NVson99/PCB_NODE_LORA_PROJECTS/DO AN TOT NGHIEP/Node_lora_altium/Image/bottom.png

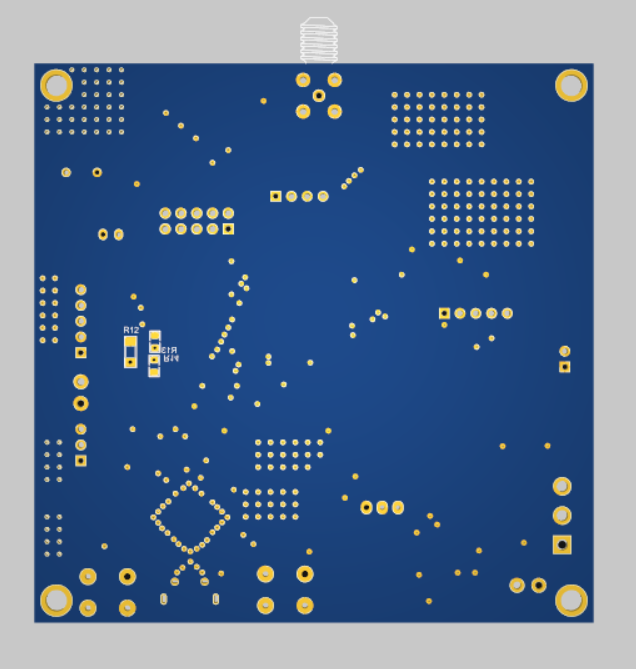
DO AN TOT NGHIEP/Node_lora_altium/Image/bottom.png
