NVson99/PCB_NODE_LORA_PROJECTS/DO AN TOT NGHIEP/Node_lora_altium/Image/TOP.2D.png

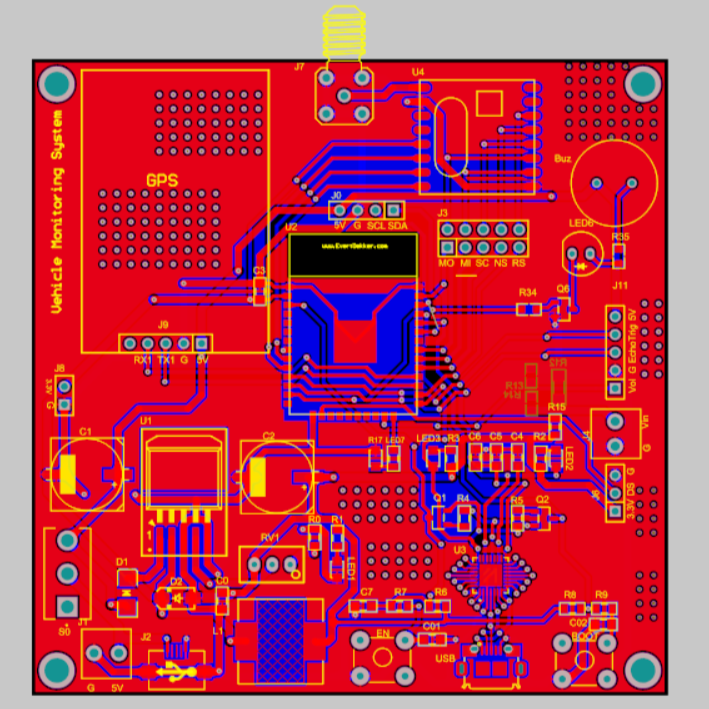
DO AN TOT NGHIEP/Node_lora_altium/Image/TOP.2D.png
