NVson99/PCB_NODE_LORA_PROJECTS/DO AN TOT NGHIEP/Node_lora_altium/Image/top.3D_2.png

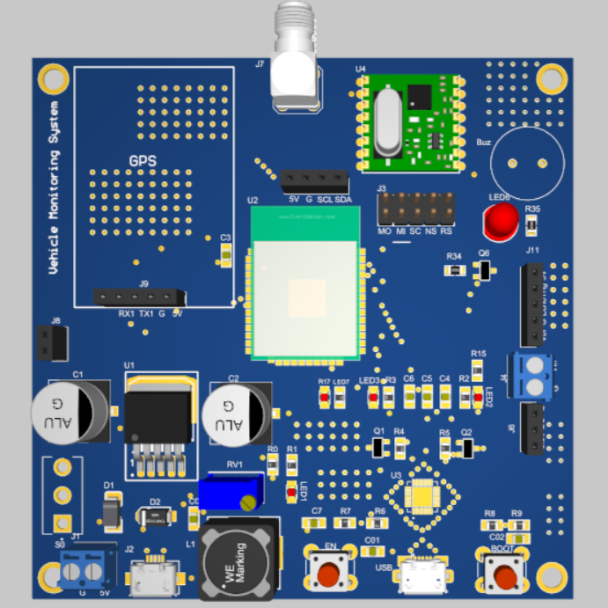
DO AN TOT NGHIEP/Node_lora_altium/Image/top.3D_2.png
