NVson99/PCB_NODE_LORA_PROJECTS/DO AN TOT NGHIEP/Node_lora_altium/BOM/BOM.csv

Comment | Description | Designator | Quantity | Man. Part Number
Button 4pin | Button 4pin | BOOT, EN | 2
PS1240P02BT | Buzzers Transducer, Externally Driven Piezo 3V 4kHz 60dB @ 3V, 10cm Through Hole PC Pins | Buz | 1
10uF | Cap SMD | C0, C4, C5, C7 | 4
1nF | Cap SMD | C01, C02 | 2
330uF | Polarized Capacitor (Axial) | C1, C2 | 2
102 | Cap SMD | C3 | 1
1uF | Cap SMD | C6 | 1
Diode SMD | Default Diode | D1 | 1
SS34 | DIODE, SCHOTTKY, 40V, 3A | D2 | 1
JP4 | WR-PHD 2.54 mm Angled Socket Header | J0 | 1
KF2 |  | J1, J4 | 2
USB-5 |  | J2 | 1
JP5x2 | WR-PHD 2.54 mm Dual Socket Header | J3 | 1
JP3 | WR-PHD 2.54 mm Angled Socket Header | J6 | 1
210111003 | CONNECTOR ANTEN | J7 | 1
JP2 | WR-PHD 2.54 mm Angled Socket Header | J8 | 1
JP5 | WR-PHD 2.54 mm Angled Socket Header | J9, J11 | 2
33uH |  | L1 | 1
LED |  | LED1, LED2, LED3, LED7 | 4
LED5MM_RED | LED, THD, 5MM, RED | LED6 | 1
SS8050 | BJT, NPN, 25v, 1.5A, SMD, SOT23 | Q1, Q2, Q6 | 3
330 | Resistor | R0 | 1
1k | Resistor | R1, R2, R3, R7, R9, R17 | 6
10K | Resistor | R4, R5, R6, R8 | 4
0.1R | RESISTOR, SMD | R12 | 1
100K | RESISTOR, SMD | R13 | 1
10K | RESISTOR, SMD | R14 | 1
4.7K | Resistor | R15 | 1
3.9K | RESISTOR, SMD | R34 | 1
440 | RESISTOR, SMD | R35 | 1
RV20K | Variable Resistor | RV1 | 1
500SSP1S2M2QEA | Slide Switch SPDT Through Hole | S0 | 1
LM2596 |  | U1 | 1
ESP32S_Module | Esp-32S | U2 | 1
CP2102 | USB to USRT converter | U3 | 1
SW96 |  | U4 | 1
OLED_Sh116 1.3" | OLED, SSD1306, 0.96", 128X64, BREAKOUT I2C | U5 | 1
CONN_USB_MICROB | CONN, USB, MICRO B, R/A, SMD, BOTTOM MOUNT | USB | 1
