NVson99/PCB_NODE_LORA_PROJECTS/DO AN TOT NGHIEP/Node_lora_altium/Gerber file/STEP_[No Variations] for Node_Bus.PcbDoc.step

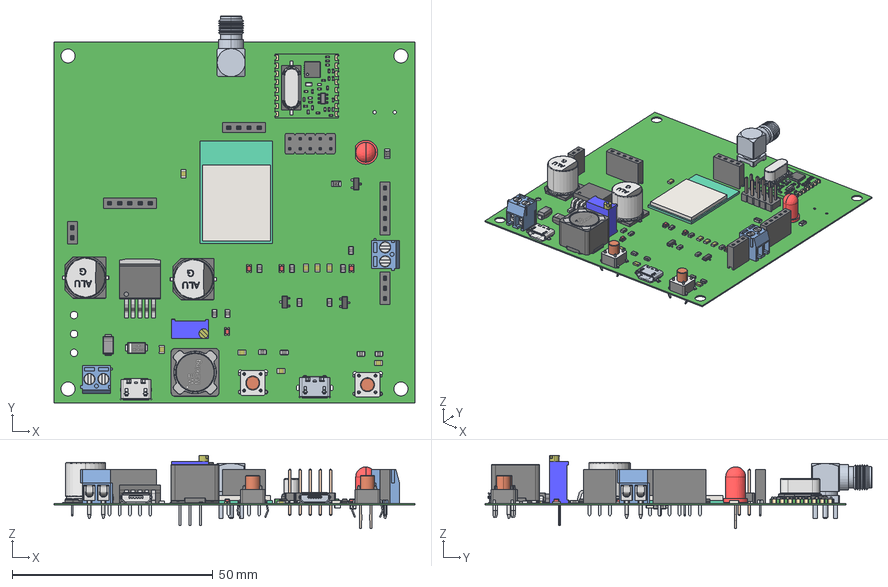
[picture p117: CAD file, 2026-10-10]
DO AN TOT NGHIEP/Node_lora_altium/Gerber file/STEP_[No Variations] for Node_Bus.PcbDoc.step
90.0 x 96.5 x 18.3 mm
6130xx11821_PIN x 19
SW3dPS-smt_resistor_packages x 8
SW3dPS-0805 SMD Resistor x 12
User Library-led_0805-red x 4
Extruded x 2
User Library-RFM22B_Board
User Library-RFM22B_SW3dPS-inductor_0402
User Library-RFM22B_SW3dPS-SOT-23-6
User Library-RFM22B_Cap0402 x 19
User Library-RFM22B_SW3dPS-inductor_0402_white x 5
User Library-RFM22B_SW3dPS-inductor_0603_white
User Library-RFM22B_QFN20
User Library-RFM22B_SW3dPS-hc49_cystal
User Library-RFM22B_Goldcontact x 16
User Library-Potenciometro Vertical
User Library-RES_2013-0805 x 4
1206 SMD Resistor
User Library-SOT23-2 x 3
LED-D5R
Umspritzung12-12_1
12x12-9mm
Core PD 12x12-9
Glue
Leadframe x 2
PIN 1
PIN 2
PIN 3
PIN 4
SMA-J-P-X-RA-TH1
6911031100xx_CAGE x 4
6911031100xx_PIN x 4
6911031100xx_VIS x 4
6130xx21121_PIN x 10
Micro USB
SW3dPS- x 2
User Library-DIOM5528X26
User Library-DO-214Aa SMA
User Library-ALU-G_Pins_1 x 2
User Library-ALU-G_Fuss_1 x 2
User Library-ALU-G_K_X_F6rper_1 x 2
User Library-ALU-G_Beschriftung_1 x 2
