NVson99/PCB_NODE_LORA_PROJECTS/DO AN CN/Node_Lora_V1/schematic/Schematic.pdf

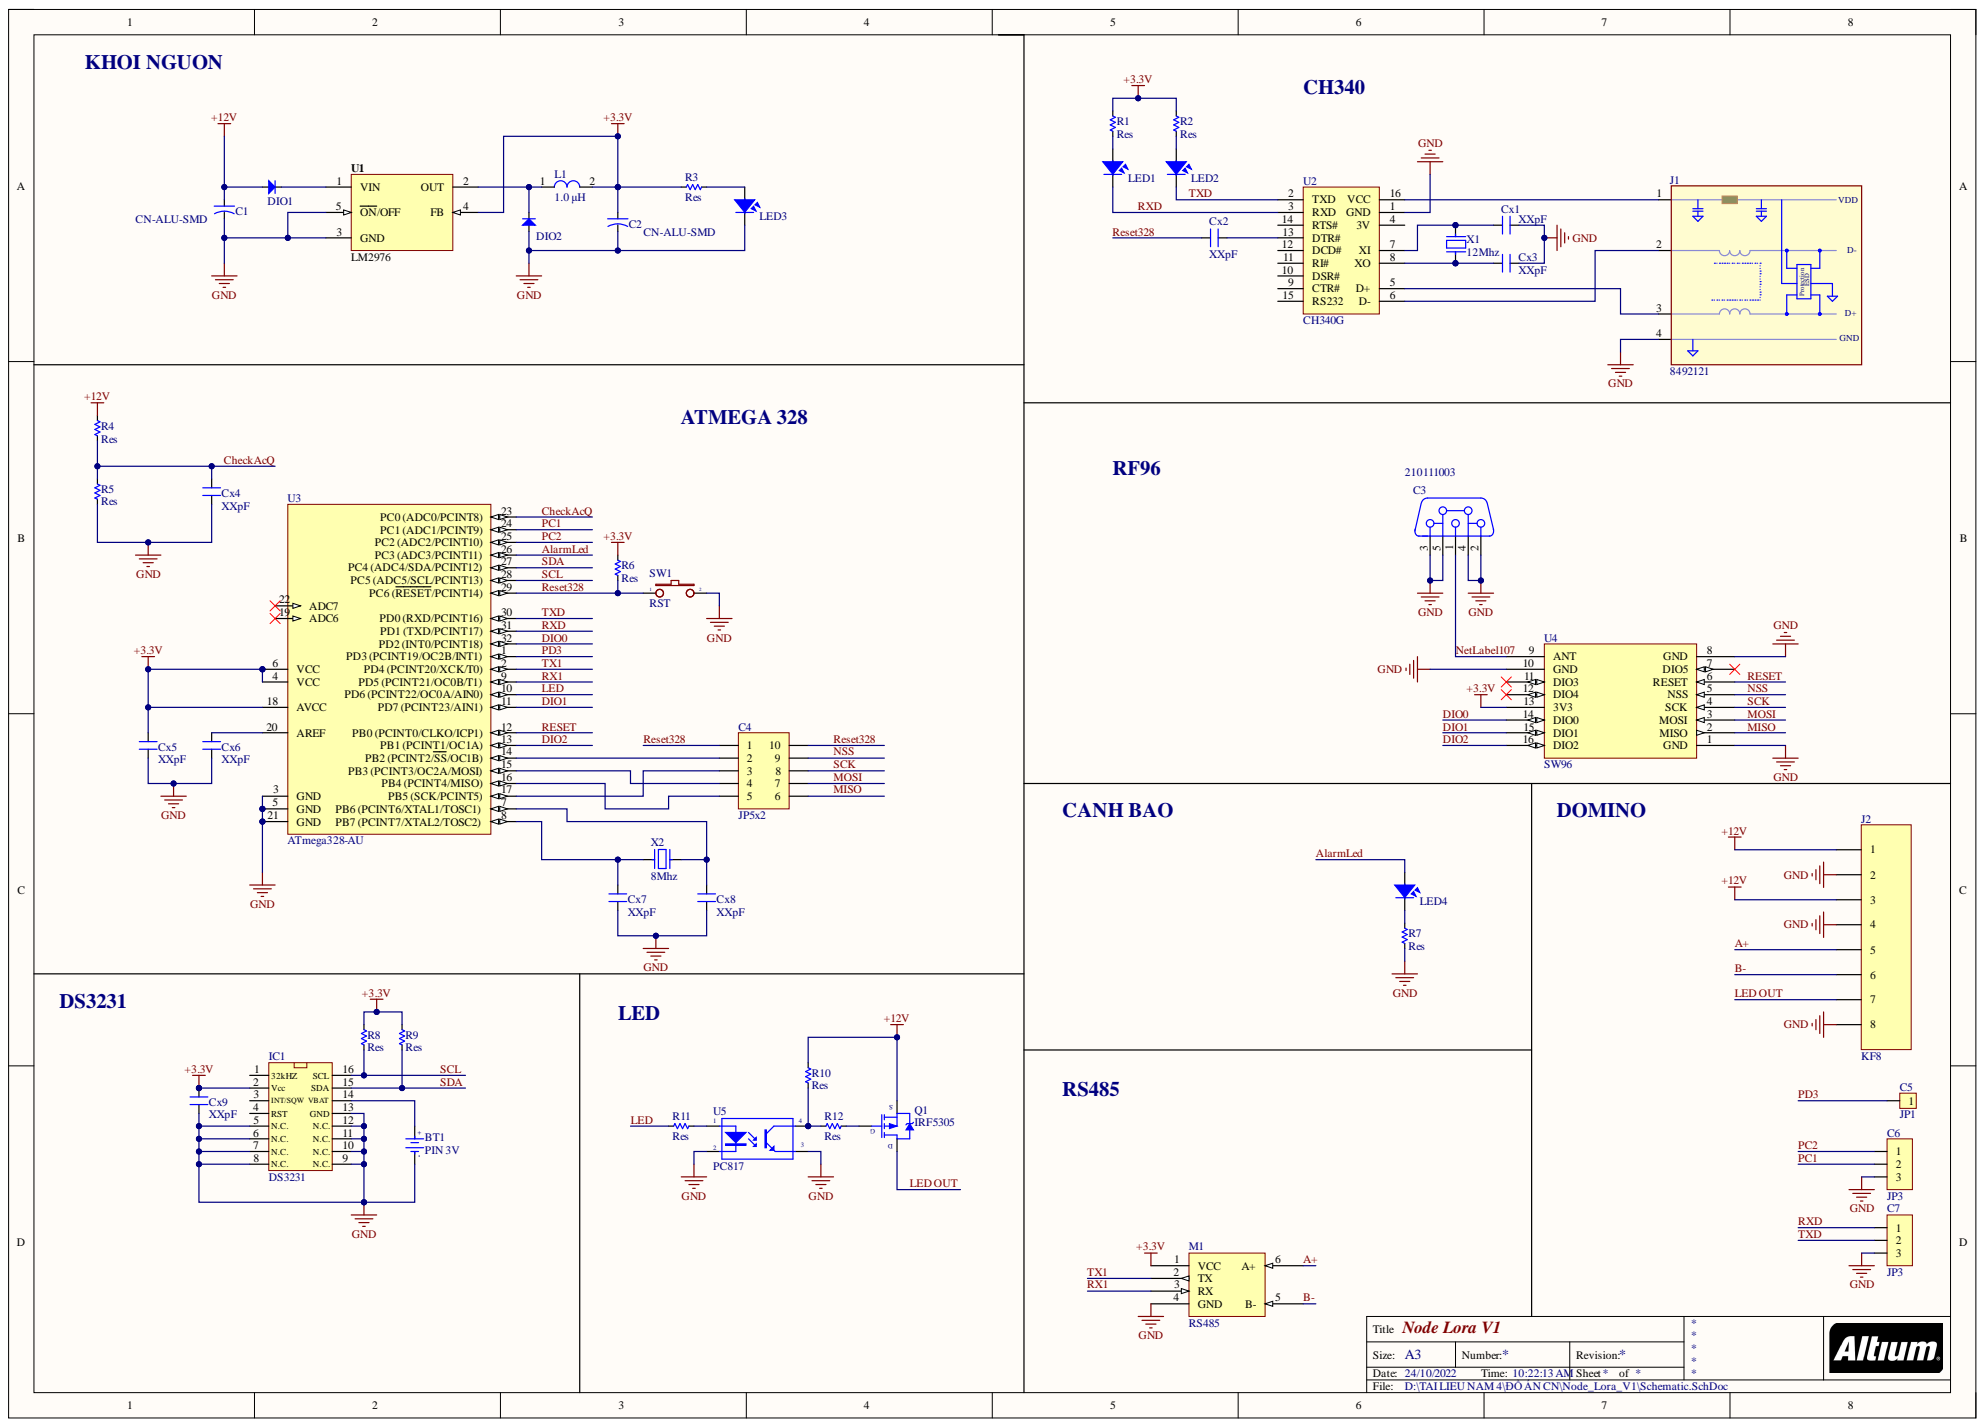
[picture p118: page 1]

N.C. 5
N.C. 6

D:\TAILIEU NAM 4\ĐỒ ÁN CN\Node_Lora_V1\Schematic.SchDoc
