NVson99/PCB_NODE_LORA_PROJECTS/DO AN TOT NGHIEP/Node_lora_altium/Gerber file/Assembly Drawings.pdf

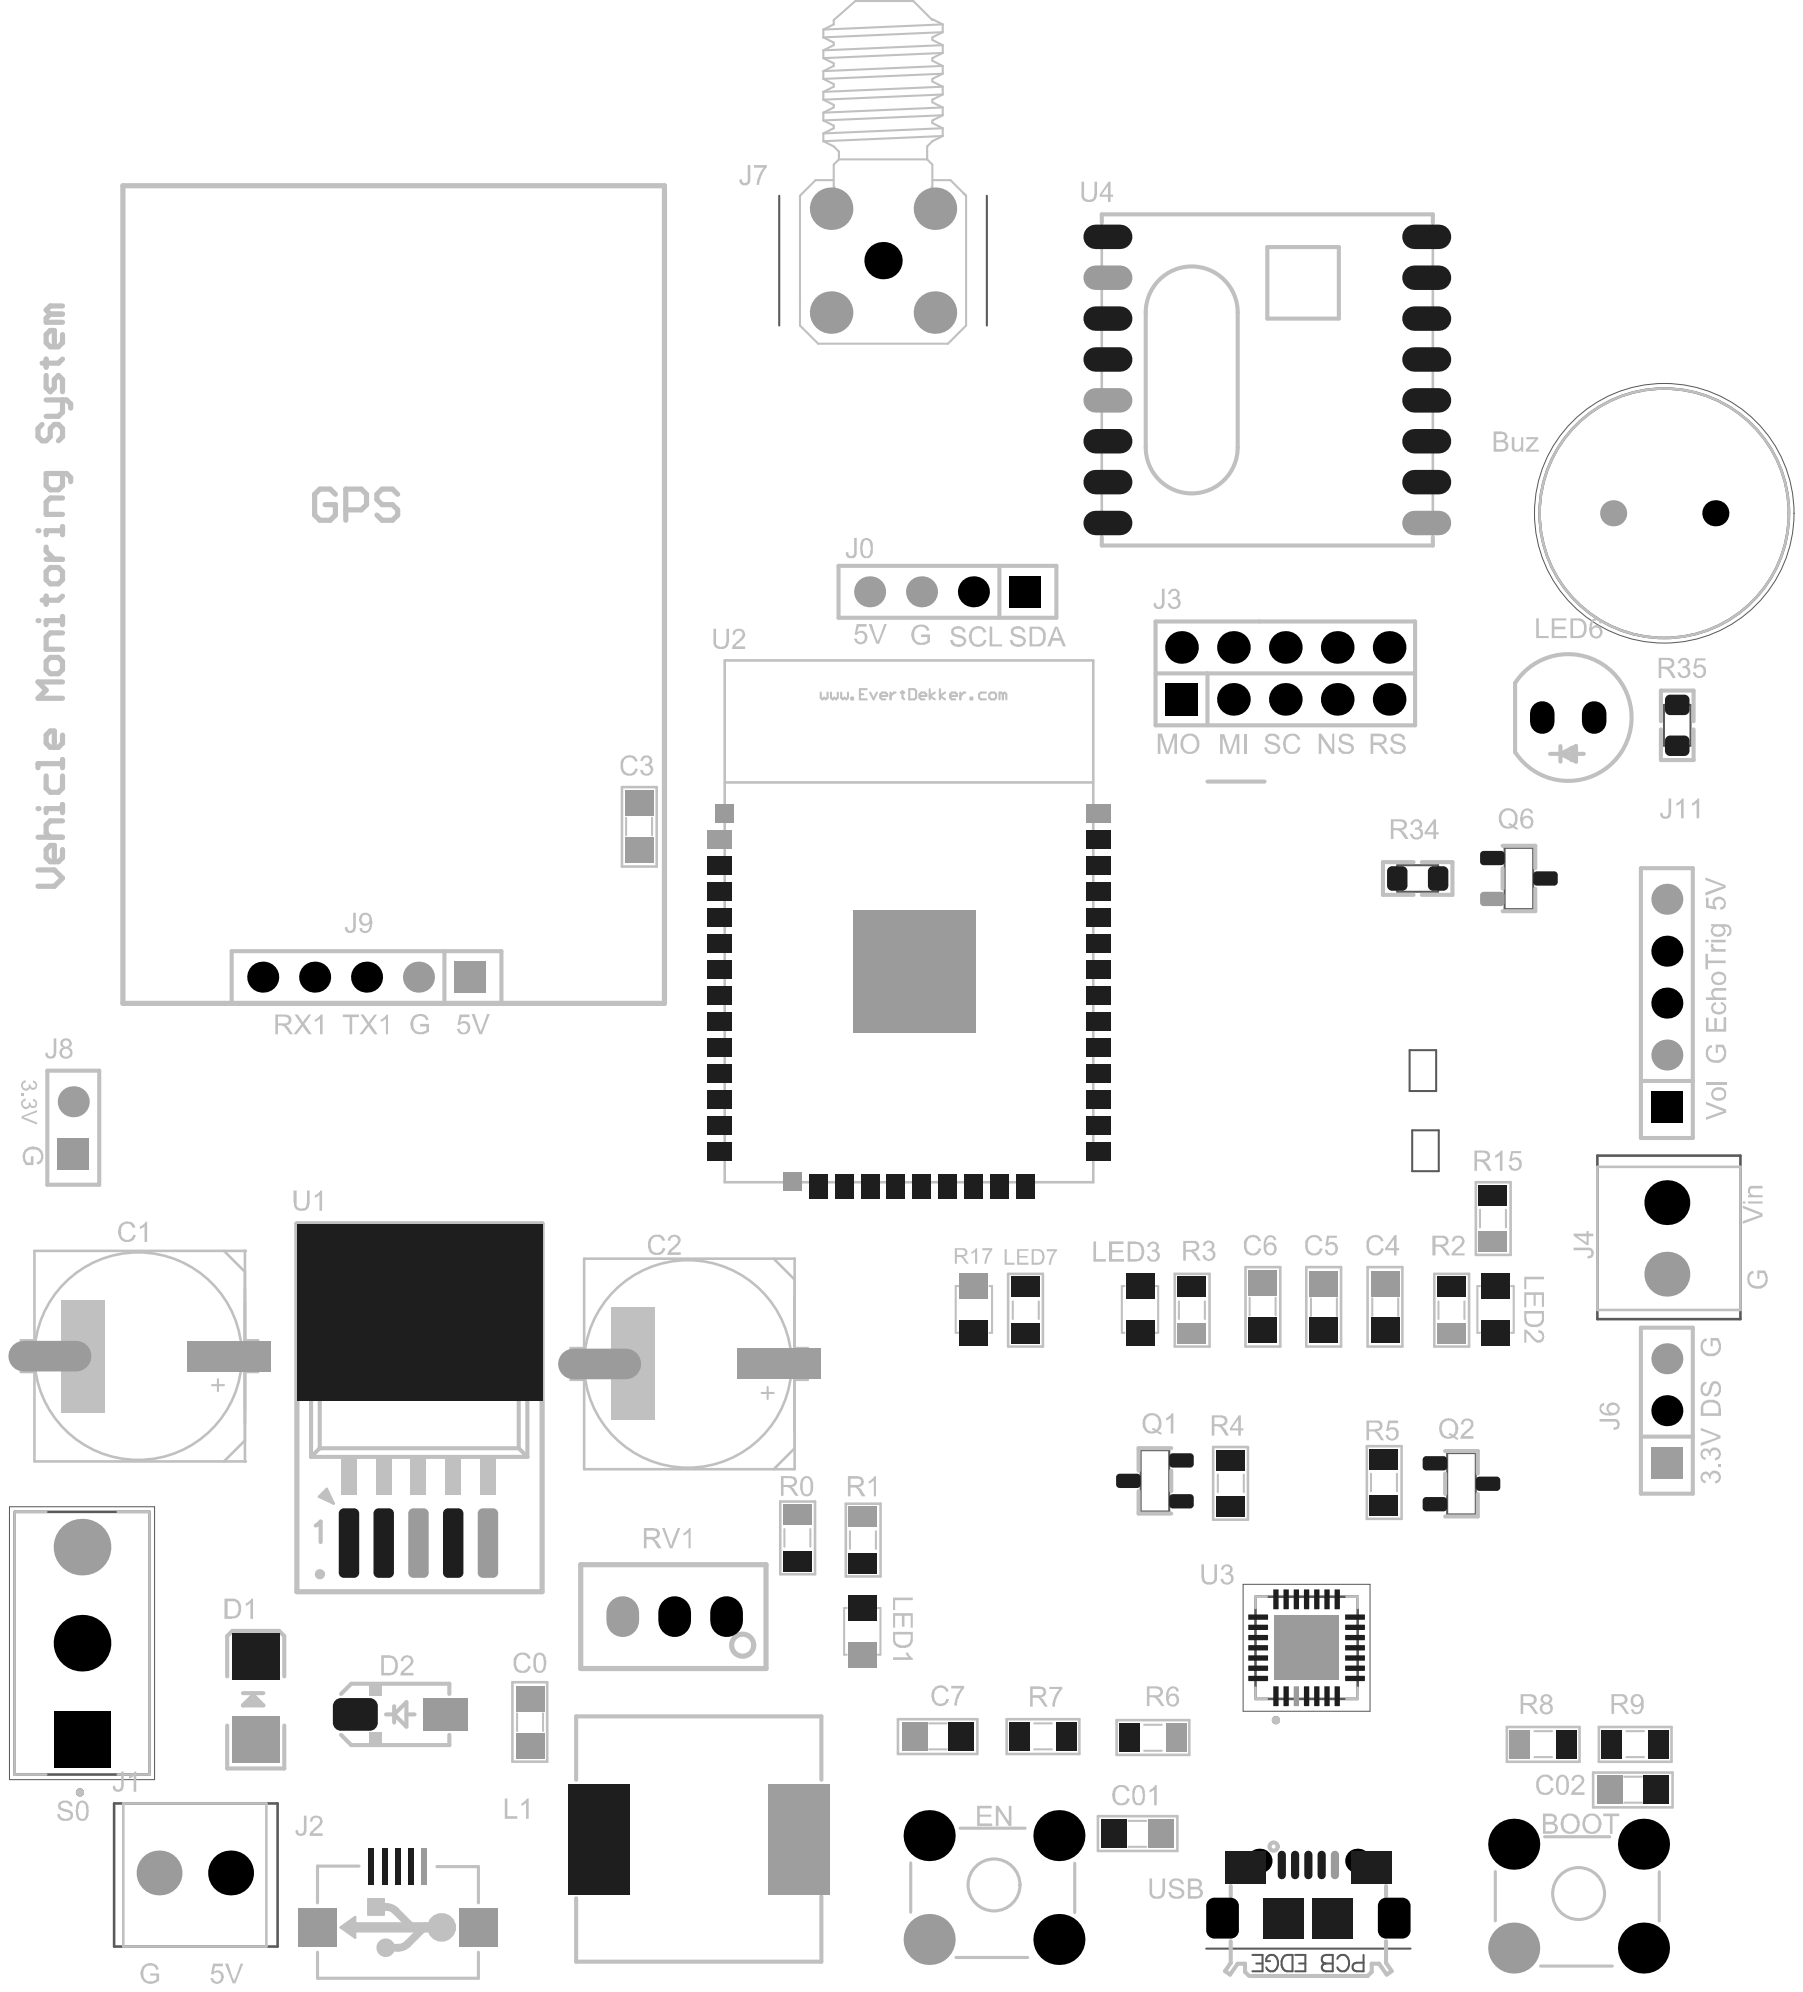
[picture p119: page 1]

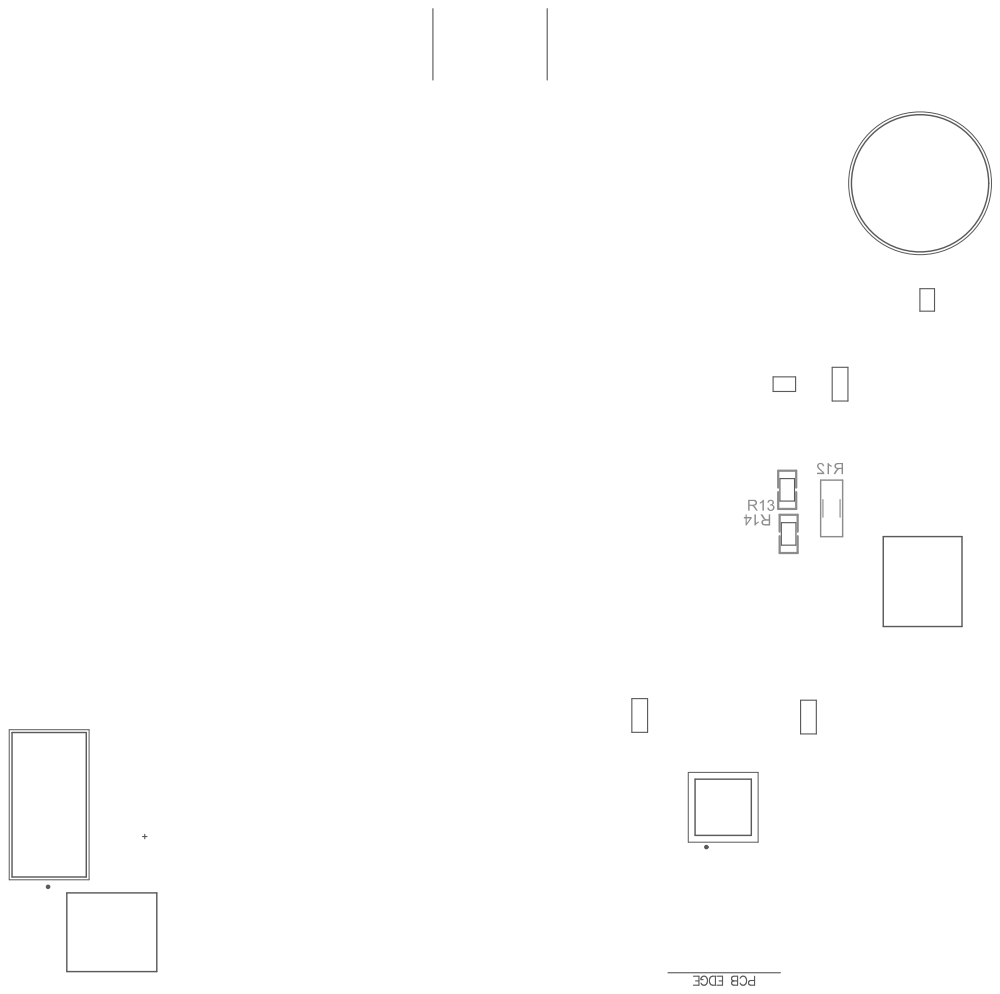
[picture p120: page 2]

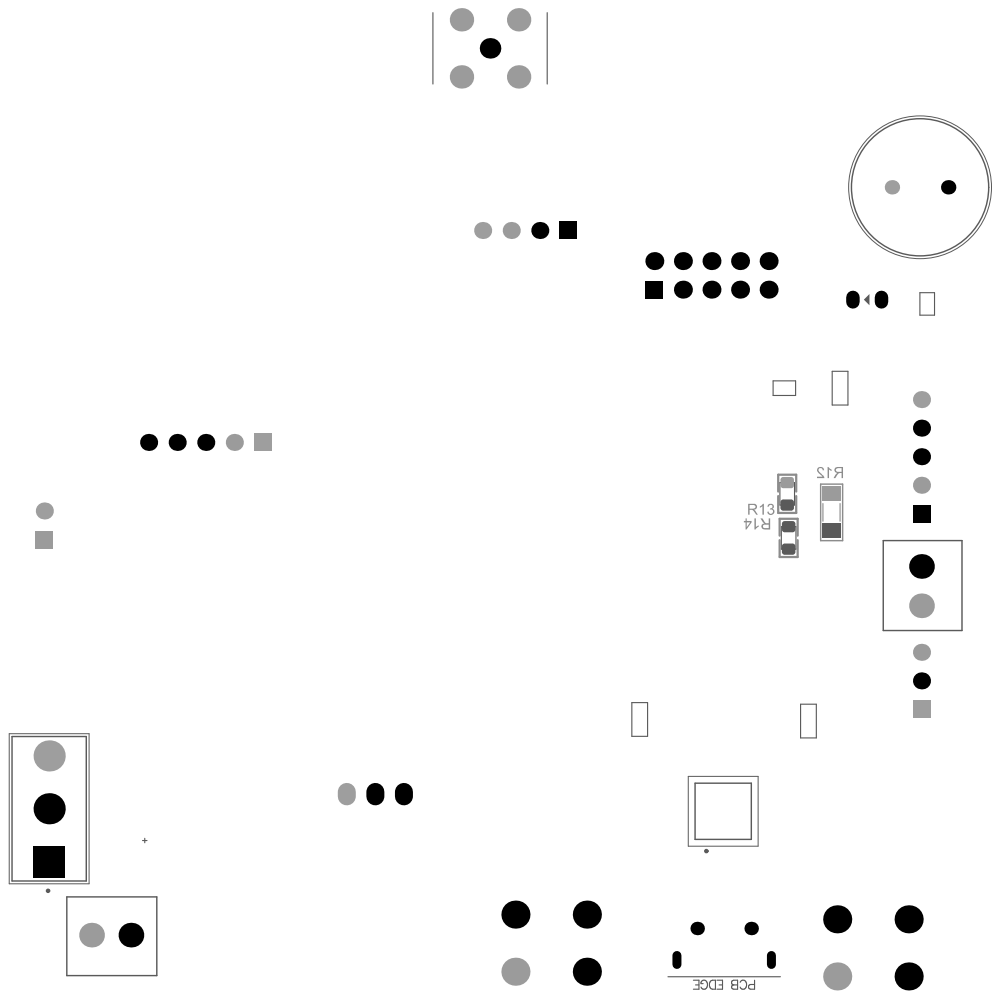
[picture p121: page 4]
