NVson99/PCB_NODE_LORA_PROJECTS/DO AN TOT NGHIEP/Node_lora_altium/schematic/Schematic PDF.pdf

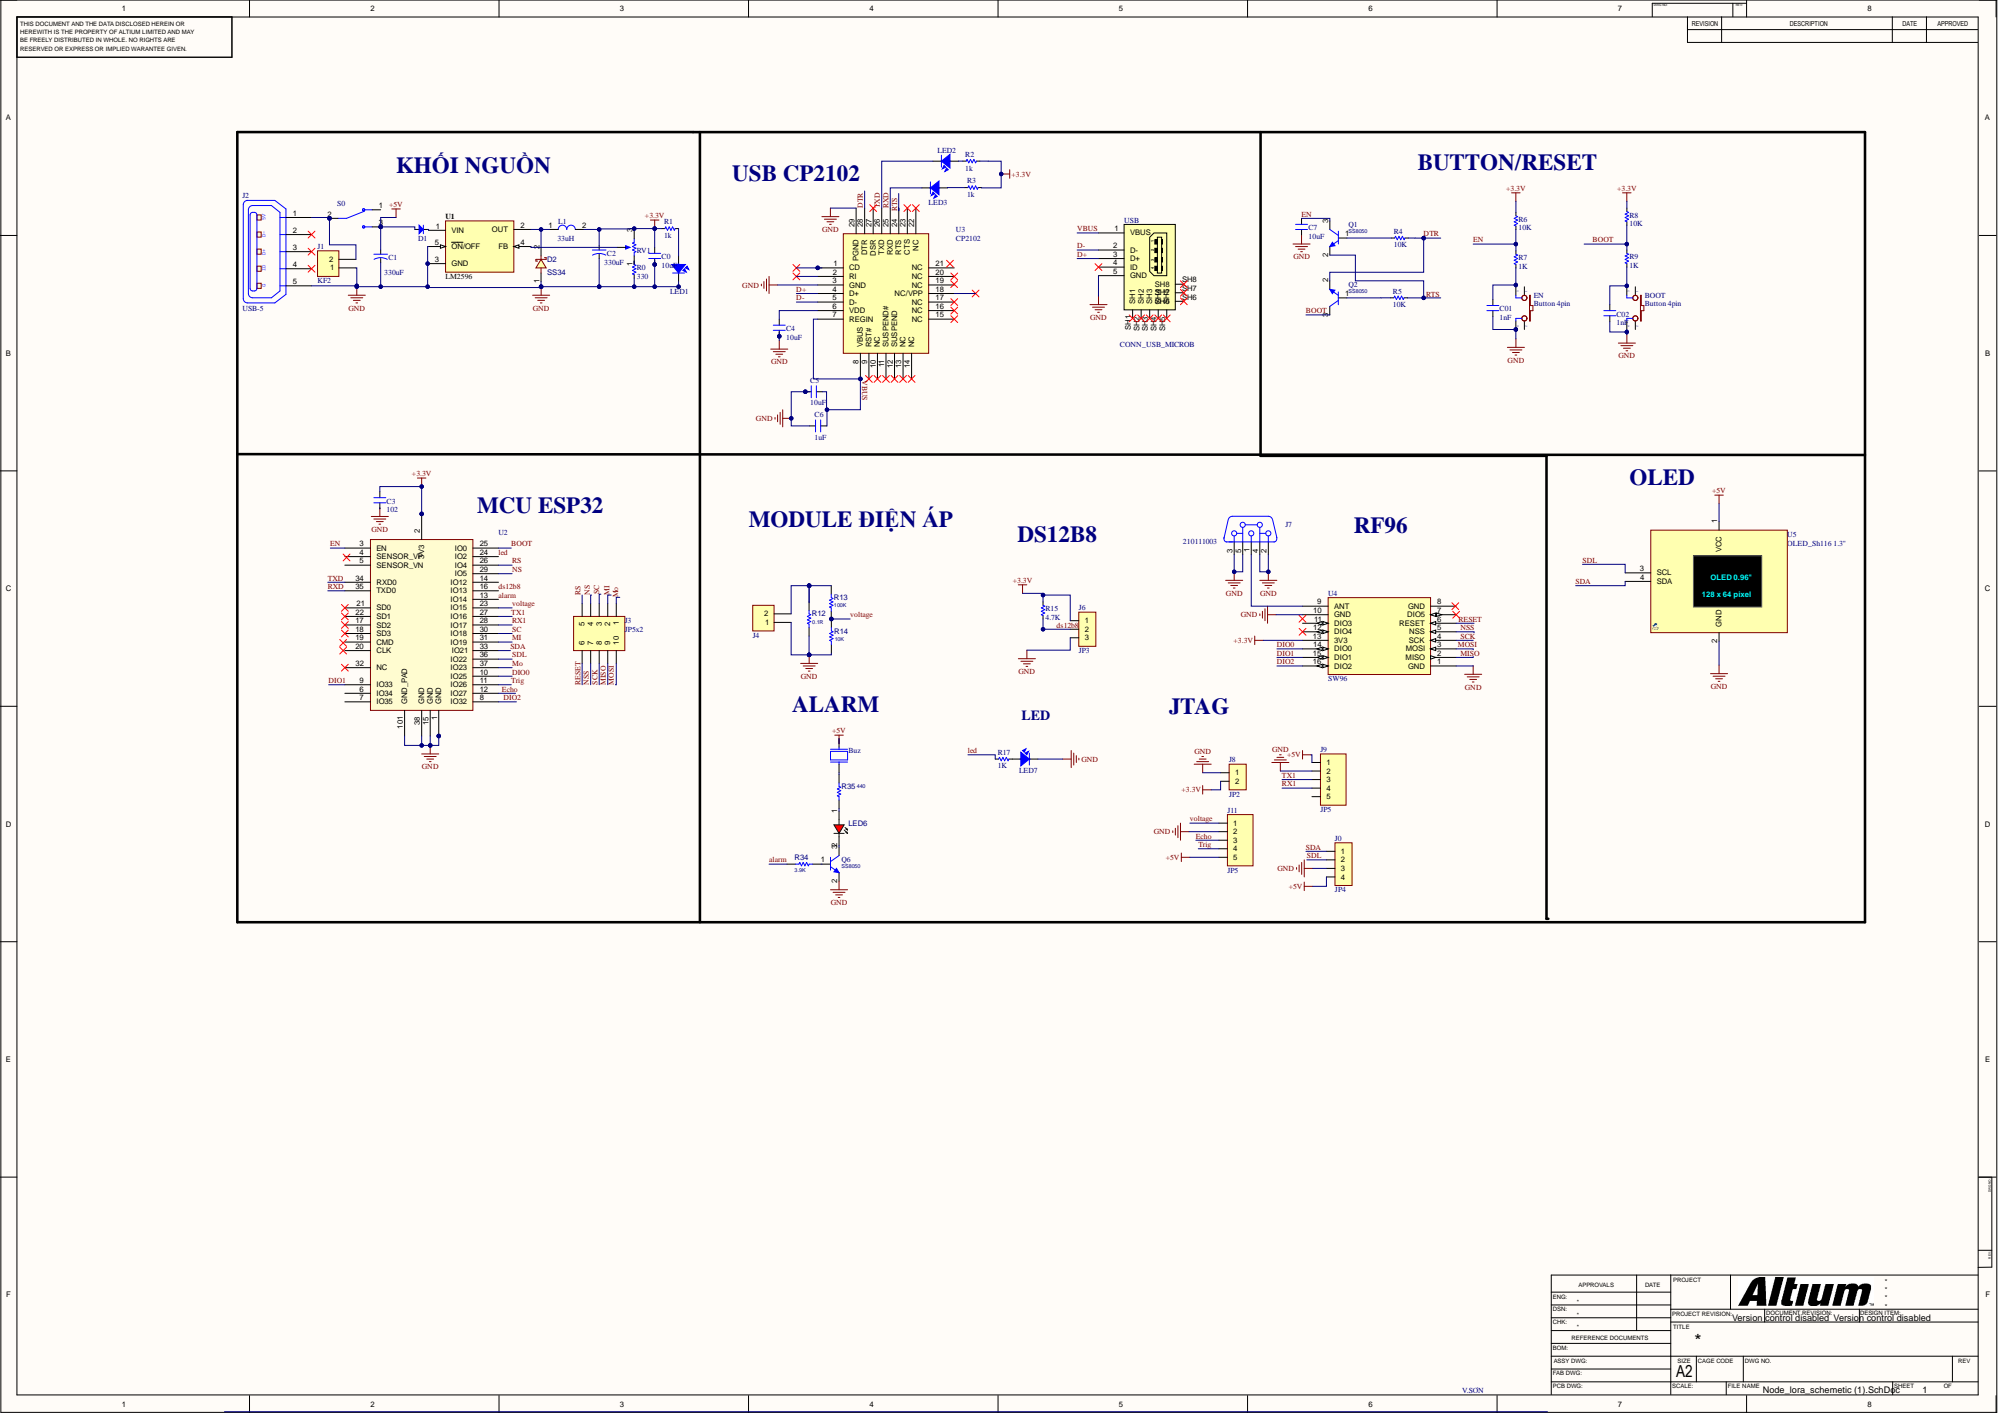
[picture p122: page 1]

THIS DOCUMENT AND THE DA TA DISCL OSED HEREIN O R HEREWITH IS THE PROPERTY OF ALTIUM LIMITED AND M AY BE FREELY DISTRIBUTED IN WHO LE. NO RIGHTS ARE RESERVED OR EXPRESS OR IMPLIED WARANTEE GIVEN. | | REVISI O N | DESCRIPTI O N | DATE | APPROVED

DATE | PRO JECT | **** APPROVALS

ENG :
** DSN:

JECT REVISION: PRO Version | DOCUMENT REVISION: control disabled Version control disabled | DESIGN ITEM :

CHK: *
