NVson99/PCB_NODE_LORA_PROJECTS/(list of files, drawings)

Other design files:
DO AN CN/Node_Lora_V1/PCB/PCB.PcbDoc
DO AN CN/Node_Lora_V1/PROJECT/Node_Lora_V1.PrjPcb
DO AN CN/Node_Lora_V1/schematic/Schematic.SchDoc
DO AN TOT NGHIEP/Node_lora_altium/PCB/Node_Bus.PcbDoc
DO AN TOT NGHIEP/Node_lora_altium/schematic/Node_lora_schemetic (1).SchDoc
