NVson99/PCB_NODE_LORA_PROJECTS/(commit log)

2026-10-10 fist commit
    [BOM.csv, Node_Bus.PcbDoc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]
2026-10-12 add bare & pcba image
    [Node_Lora_V1.PrjPcb, PCB.PcbDoc, Schematic.SchDoc]
